eymas/WillyTheRobot/README.md

# WillyTheRobot
Minor FT - Project Willy The Robot
