eymas/WillyTheRobot/documentation/hardware-design/sections/glossary.tex

\section{glossary}
\begin{itemize}
\item \label{trm::imu} IMU - Inertia Measurement Unit, a sensor that can detect velocities in 3 to 9 axis.
\item \label{trm::PPR} PPR - Pulses Per Revolution, amount of signals generated in a single full rotation of the axis.
\end{itemize}
