eymas/WillyTheRobot/documentation/hardware-design/sections/MotorController.tex

\section{MotorController}

\subsection{Mechanical setup}

\subsection{Electrical setup}
At the start of the project the rotary encoders where disconnected and damaged. 
New rotary

The wiring for the sonars can be found in the schematic below (reused from previous group):

\begin{figure}[H]
\centering
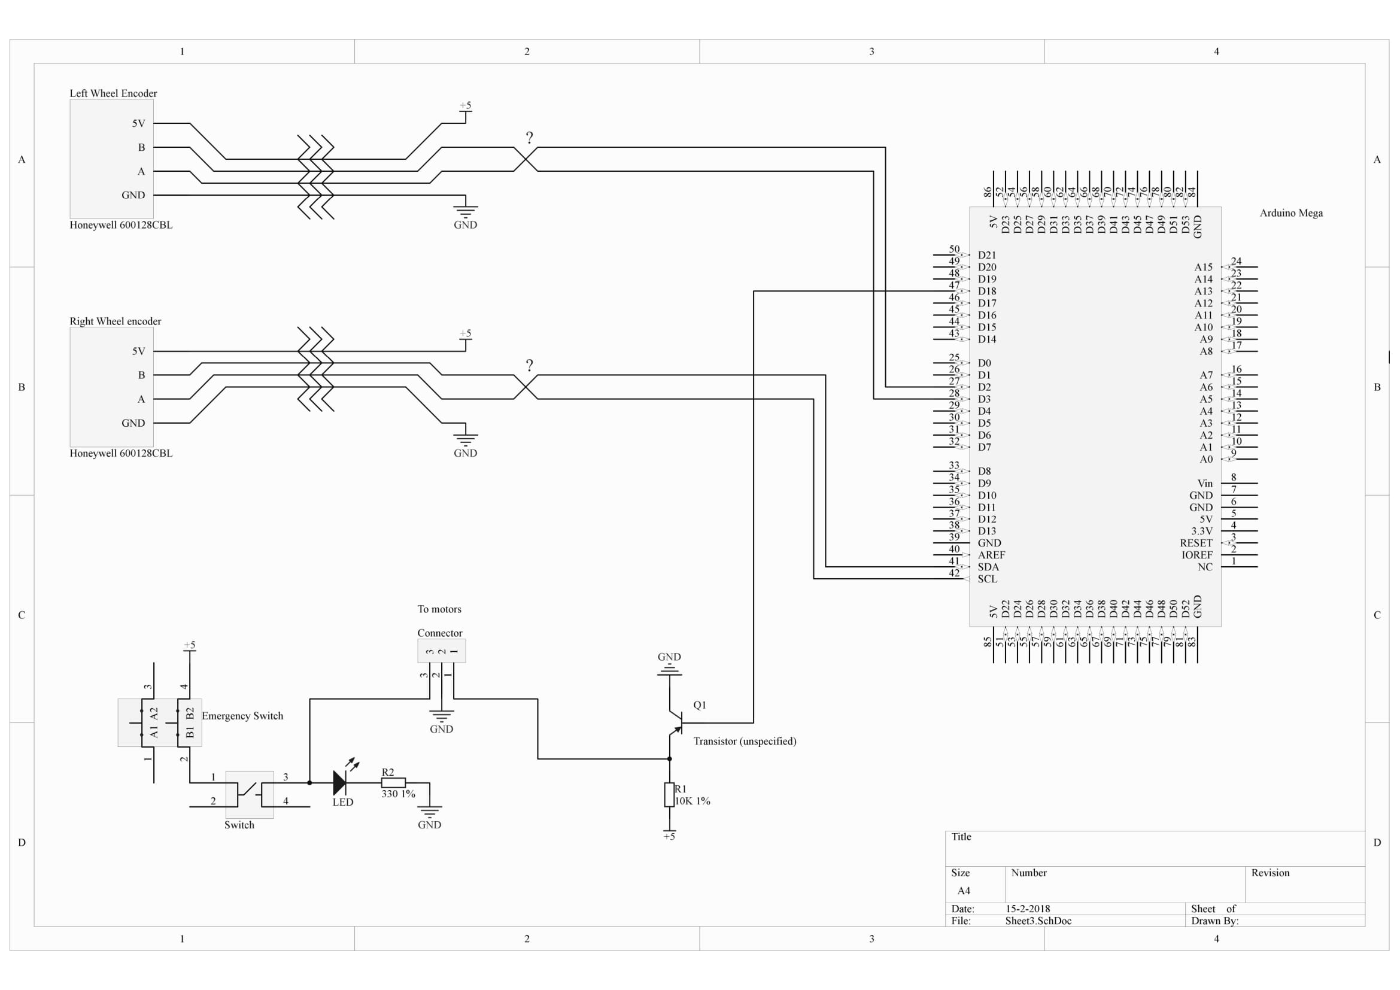
[picture p16: documentation/hardware-design/images/MotorController.jpg]

\caption{Wiring setup for the motor controller}
\label{fig::wiringMotor}
\end{figure}
