eymas/WillyTheRobot/documentation/tech-design/sections/glossary.tex

\section{Glossary}
\begin{itemize}
\item \label{trm::MSB} MSB  - Most Significant Bit(s)
\item \label{trm::LSB} LSB  - Least Significant Bit(s)
\item \label{trm::WTR} WTR  - Willy The Robot
\item \label{trm::PPR} PPR - Pulses per revolution
\item \label{trm::quad} Quadrature encoder - Two channel encoder with channel B phase shifted 90 degrees over channel A.
\end{itemize}
