eymas/WillyTheRobot/documentation/advice/sections/glossary.tex

\section{glossary}
\begin{itemize}
\item \label{trm::imu} IMU - Inertia Measurement Unit, a sensor that can detect velocities in 3 to 9 axis
\item \label{trm::wtr} WTR - Willy the Robot
\item \label{trm::kbs} KBS - \textit{Kenmerkende beroeps situatie}
\item \label{trm::asrs} ASRS - Automated storage and retrieval system
\item \label{trm::ros} ROS - Robotic operating system
\item \label{trm::rviz} RVIZ - 3D visualization tool for ROS
\item \label{trm::amcl} AMCL - Adaptive Monte Carlo Localization algorithm
\item \label{trm::teb} TEB - Timed Elastic Band
\item \label{trm::PGE} PGE - Penny \& Giles Motor controller, used in the base of the electric wheelchair
\end{itemize}
