eymas/WillyTheRobot/documentation/analysis-improvements/sections/closed-loop-control.tex

\section{Closed Loop Drive Control}
\subsection{Introduction}
WTR currently has an "open loop control system" \cite{openloop} that controls how it turns and drives.
There are no sensors used to provide feedback, which could be used to control and adjust accordingly.
This is a major drawback, because the robot is already quite difficult to control.
While it does not move very quickly, the motors have a lot of power behind them.
Should one of the wheels receive less power from the motor than the other, it will affect the trajectory of WTR, resulting in poor execution of the instructions, regardless of the accuracy of the path-finding.

\subsection{System Description}
\label{subs::SysDes}
WTR's mobility scooter base consists of two powered wheels at the front and two wheels on pivot each at the rear.
The two powered wheels each have a separate electrical motor.
This set-up is quite sensitive to small variations between the two motors, though it does allow for a good range of movements.

\subsection{Current Setup}
An Arduino Mega 2560 (based on the ATmega2560 \cite{ardMega}) is used to receive input from the laptop or Raspberry Pi used as core control unit, and then translates that into instructions for the motors from the mobility scooter.
The commands sent are translated into a corresponding power output of the wheels via the integrated motor controller of the scooter.
Two commands can be sent, one for the speed of the motors and one for rotation.
Both fall within a range of 100 to -100.
Unfortunately, this set-up does not allow for independent control of both motors, but an appropriate model of the system could be used to approximate that level of control through careful control of the turn variables.

\subsection{Improvements}
Two sensors will be added to the axles of both wheels, which allow WTR to use the speed and rotation of the wheels as feedback.
These sensors will be controlled via a micro-controller, likely an Arduino Uno \cite{ardUno}, since those are already available and simple to use.
This set-up would allow for an integrated closed loop control system using negative feedback.
An overview can be found in figure~\ref{fig::cllp}.
\begin{figure}[H]
\centering
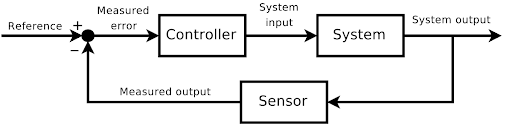
[picture p27: documentation/movement-research/images/controlmodel.png]

\caption{Example of the closed loop control system}
\label{fig::cllp}
\end{figure}
\newpage

\subsection{Model Of Control}
\subsubsection{Base}
As explained in 'System Description' \ref{subs::SysDes}, the motors can only be controlled through two output variables.
These two variables are \code{drive} output and \code{turn} output, both limited to values between 100 and -100.
These input are sent directly from the Arduino Mega, which applied the limits to the received values.
An overview can be found in table~\ref{tab::varoverview}
\begin{figure}[H]
\centering
\begin{tabular}{|l|l|c|c|l|l|}
\hline
\textbf{Nr.} & \textbf{Variable(s)} & \textbf{Left(+)} & \textbf{Right(-)} & \textbf{Min} & \textbf{Max} \\ \hline
1 & Input Turn 	& \multicolumn{2}{c|}{Turn\_Input} 				& - 		& -		\\ \hline
2 & Input Drive 	& \multicolumn{2}{c|}{Drive\_Input} 				& - 		& - 		\\ \hline
3 & Drive Output & \multicolumn{2}{c|}{Drive\_Output = Drive\_Input}	& -100 	& +100 	\\ \hline
4 & Turn Output 	& \multicolumn{2}{c|}{Turn\_Output = Turn\_Input}	& -100	& +100	\\ \hline
\end{tabular}
\caption{Overview of inputs and outputs of the original system}
\label{tab::varoverview}
\end{figure}

\subsubsection{Control Model}
To be able to create a controller which can control the speed of the wheels depending on input based on both the drive and input values, a direction definition has to be set up first.
The definition is:

\begin{itemize}
\item \code{Turning left will be a positive input value and a corresponding positive left wheel speed and a negative or lesser right wheel speed. Turning right will correspond with a negative input value and a positive right wheel speed and a negative or lesser left wheel speed}
\item \code{Moving forward corresponds with a positive input value and wheel speed, while moving backwards corresponds with a negative input value and negative wheel speed}
\end{itemize}

This definition is compliant with ROS and allows the construction of a control model which is shown in figure \ref{fig::controldiagram} and figure \ref{tab::closedoverview}.
The turn and drive inputs are received from ROS, the rotary encoders are read out by the arduino mega and the actual drive and turn speed are calculated.
Using both the reference speed inputs and the actual speeds the errors are calculated and send the PID controllers. 
These controllers then return an output signal which can be send to the motors.
The chosen controller $(C(s))$ is discussed here \ref{sec::controller}

\begin{figure}[H]
\centering
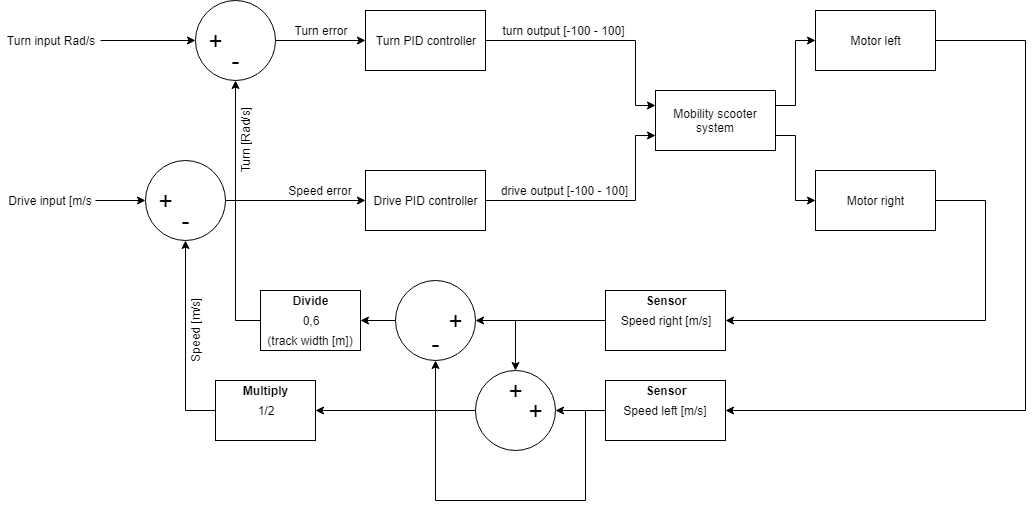
[picture p28: documentation/analysis-improvements/images/BlockDiagramCLCSR0.png]

\caption{Overview of the system integrated with closed loop control system}
\label{fig::controldiagram}
\end{figure}

\begin{figure}[H]
\centering
\begin{tabular}{|l|l|C{8cm}|c|c|}
\hline
\textbf{Nr.} 	& \textbf{Variable(s)}		&\textbf{Calculation}								         & \textbf{Unit} 	\\ \hline
1			    & Turn\_Input 			    & - 											             & [Rad/s] 		\\ \hline
2			    & Drive\_Input 				& - 											             & [m/s] 		    \\ \hline
3			    & Speed\_Sensor\_Right 		& $ Rad/s \cdot Wheel Radius $ 					         & [m/s] 		\\ \hline
4			    & Speed\_Sensor\_Left 		& $ Rad/s \cdot Wheel Radius $ 					         & [m/s] 		\\ \hline
5			    & Turn\_Speed				& $ (Speed\_Sensor\_Right - Speed\_Sensor\_Left)/0.6) $	 & [Rad/s]		\\ \hline
6			    & Drive\_Speed				& $ (Speed\_Sensor\_Right + Speed\_Sensor\_Left)/0.5) $ & [m/s]		    \\ \hline
5			    & Turn\_Error				& $ Turn\_Input - Turn\_Speed $						     & [Rad/s]		\\ \hline
6			    & Drive\_Error				& $ Drive\_Input - Drive\_Speed $ 					     & [m/s]		    \\ \hline
7			    & Turn\_Output  				& $ Turn\_Error \cdot Ct(s) $ 							 & - 			\\ \hline
8			    & Drive\_Output 				& $ Drive\_Error \cdot Cd(s) $							 & - 			\\ \hline

\end{tabular}
\caption{Overview of input and outputs in the closed loop system}
\label{tab::closedoverview}
\end{figure}
\footnotetext[1]{difference in max speed of the wheel while turning compared to max speed while driving straight}
\footnotetext[2]{Sensors must be able to determine turning direction}

\subsection{Controller}
\label{sec::controller}
The speed will be controlled by a PID-controller [\ref{trm::PIcontroller}], as shown in figure \ref{fig::picontrol}.
The initial gain will be controlled by the proportional factor $K\_p$ and the long term error by the integrating action $K\_i$. The $K\_i$ action has to be limited in order to prevent integral wind-up, and the $K\_p$ action has to be chosen so that it will not introduce too much overshoot and very little oscillation.

\begin{figure}[H]
\centering
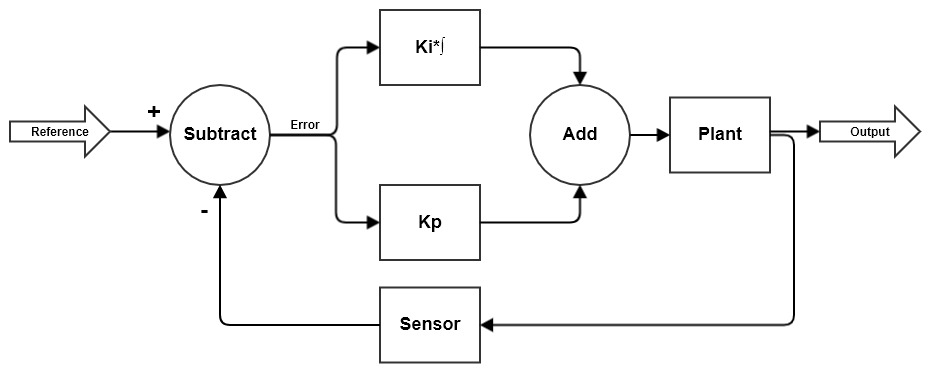
[picture p29: documentation/movement-research/images/BlockDiagramPI_R0.jpg]

\caption{PI-Controller}
\label{fig::picontrol}
\end{figure}

\newpage
