eymas/WillyTheRobot/documentation/tech-design/techdesign.tex

\documentclass{article} % article doctype, possible font size range from 8pt to 20pt with not all being avaiable.
\title{\huge Willy The Robot Technical Design Q1-Q2 2019}
\author{Jeroen van 't Hul\\S1139163  \and Thomas Zwaanswijk\\s1089273 \and Tom van den Noort\\s1101124}
\date{\parbox{\linewidth}{\centering
	\today\endgraf\bigskip
	Supervisor \hspace*{3cm} Main Stakeholder \endgraf\medskip
	Mischa Mol \hspace*{3cm} Ilja Clabbers \endgraf\bigskip
	Windesheim Zwolle\endgraf}} 

% include packages
\usepackage{graphicx}
\usepackage{caption}
\usepackage{mathabx}
\usepackage{wrapfig}
\usepackage[margin=1.0in]{geometry} % sets page margin, 2.0in is default.
\usepackage{titlesec}
\usepackage{hyperref}
\usepackage[table,xcdraw]{xcolor}
\usepackage{float}
\usepackage[export]{adjustbox}
\usepackage{todonotes}
\usepackage{indentfirst}
\usepackage{blindtext}
\usepackage{scrextend}
\usepackage{listings}
%\usepackage{siunitx}
%\usepackage{multirow}	% used for table multirow support
%\usepackage{longtable} % Allows tables to roll over into a new page.
\usepackage[nottoc,numbib]{tocbibind} % Adds bibliography / references to TOC and numbers that section.
\usepackage{array}
\usepackage{footnote}

% ----- custom commands ----- %
% Wrapper for paragraph command. Forces newline after paragraph title
\newcommand{\myparagraph}[1]{\paragraph{#1}\mbox{}\\} % Without \mbox{} all newlines will be ignored, making the first sentence appear on the same line as a paragraph title.
% monospace codeblock
\def\code#1{\texttt{#1}}
% changing the ToC depth in the document enviroment
\newcommand{\changelocaltocdepth}[1]{%
	\addtocontents{toc}{\protect\setcounter{tocdepth}{#1}}%
	\setcounter{tocdepth}{#1}%
}

\newcolumntype{L}[1]{>{\raggedright\let\newline\\\arraybackslash\hspace{0pt}}m{#1}}
\newcolumntype{C}[1]{>{\centering\let\newline\\\arraybackslash\hspace{0pt}}m{#1}}
\newcolumntype{R}[1]{>{\raggedleft\let\newline\\\arraybackslash\hspace{0pt}}m{#1}}

% general listing styling
\lstset{
	numbers=left,
	breaklines=true,
	backgroundcolor=\color{gray},
	tabsize=4,
	basicstyle=\ttfamily,
}

\makesavenoteenv{tabular}
\makesavenoteenv{table}

\setcounter{tocdepth}{2} % only part,chapters,sections, subsections appear in ToC

\addtokomafont{labelinglabel}{\sffamily}

\DeclareCaptionFormat{cancaption}{#1#2#3\par} % Normal format actually
\DeclareCaptionLabelFormat{cancaptionlabel}{#1}
\captionsetup[figure][number]{format=cancaption,labelformat=cancaptionlabel}
\graphicspath { {images/}{../images/} }

\begin{document}
\maketitle

\begin{figure}[H]
\centering

\end{figure}
\thispagestyle{empty}
\newpage
\setcounter{page}{1}
\tableofcontents
\newpage

% Sections
\input{sections/introduction.tex}
\input{sections/ROS.tex}
\input{sections/motor-controller.tex}
\input{sections/imu.tex}
\input{sections/teb-local-planner.tex}

\appendix % all sections after this are appendices
\input{sections/glossary.tex}
% Bibliography:
\newpage
\bibliographystyle{ieeetr}
\bibliography{references}

\end{document}
