eymas/WillyTheRobot/documentation/project-agreements/sections/schedule.tex

\section{Schedule}
The following table describes the schedule of the project.
\begin{center}
\begin{tabular}{|l|l|}
\hline
\textbf{Week} & \textbf{Activities} \\ \hline
1: 28 January 2019 & Introduction \\ \hline
2: 4 February 2019 & Start sprint 0 \\ \hline
3: 11 February 2019 & Start sprint 1 \\ \hline
4: 18 February 2019 & Holiday \\ \hline
5: 25 February 2019 &  \\ \hline
6: 4 March 2019 & Start sprint 2 \\ \hline
7: 11 March 2019 &  \\ \hline
8: 18 March 2019 & Start sprint 3 \\ \hline
9: 25 March 2019 &  \\ \hline
10: 1 April  2019 & Start sprint 4 \\ \hline
11: 8 April 2019 &  \\ \hline
12: 15 April 2019 & Start sprint 5 \\ \hline
13: 22 April 2019 &  \\ \hline
14: 29 April 2019 & Start sprint 6 \\ \hline
15: 6 May 2019 &  \\ \hline
16: 13 May 2019 & Start sprint 7 \\ \hline
17: 20 May 2019 &  \\ \hline
18: 27 May 2019 & Start sprint 8 \\ \hline
19: 3 June 2019 &  \\ \hline
20: 10 June 2019 & Project deadline \\ \hline
\end{tabular}
\end{center}

\subsection{Global Sprint Planning}
\noindent \textbf{Sprint 0}\\
Introduction of the projects, team building, contacting stakeholders, project plan, contact with previous groups\\
\textbf{Sprint 1}\\
Getting to grips with Willy and ROS (Robotic Operating System), update WillyWiki\\
\textbf{Sprint 2}\\
Tweak file structure, work on manual controls and diagnose problems\\
\textbf{Sprint 3}\\
begin updating controls on Willy\\
\textbf{Spring 4}\\
Start work on move\_ base update to accommodate rotary encoders\\
\textbf{Sprint 5}\\
Adapt emergency behaviours to accommodate WTR's unusual structure\\
\textbf{Sprint 6} \\
Continue autonomous driving\\
\textbf{Sprint 7}\\
Testing\\
\textbf{Sprint 8}\\
Bugfixing + preparation for Winnovation \\

Any spare time will be dedicated to improving other features, but the scope of those is dependent of whether or not any time is left, and the interest of the group itself.
Additionally, the way Willy is currently built leaves a lot to be desired, so in any spare time improvements in the mounting of hardware and cable-management will also be made.

\newpage
