eymas/WillyTheRobot/documentation/advice/images/rosOverview.png

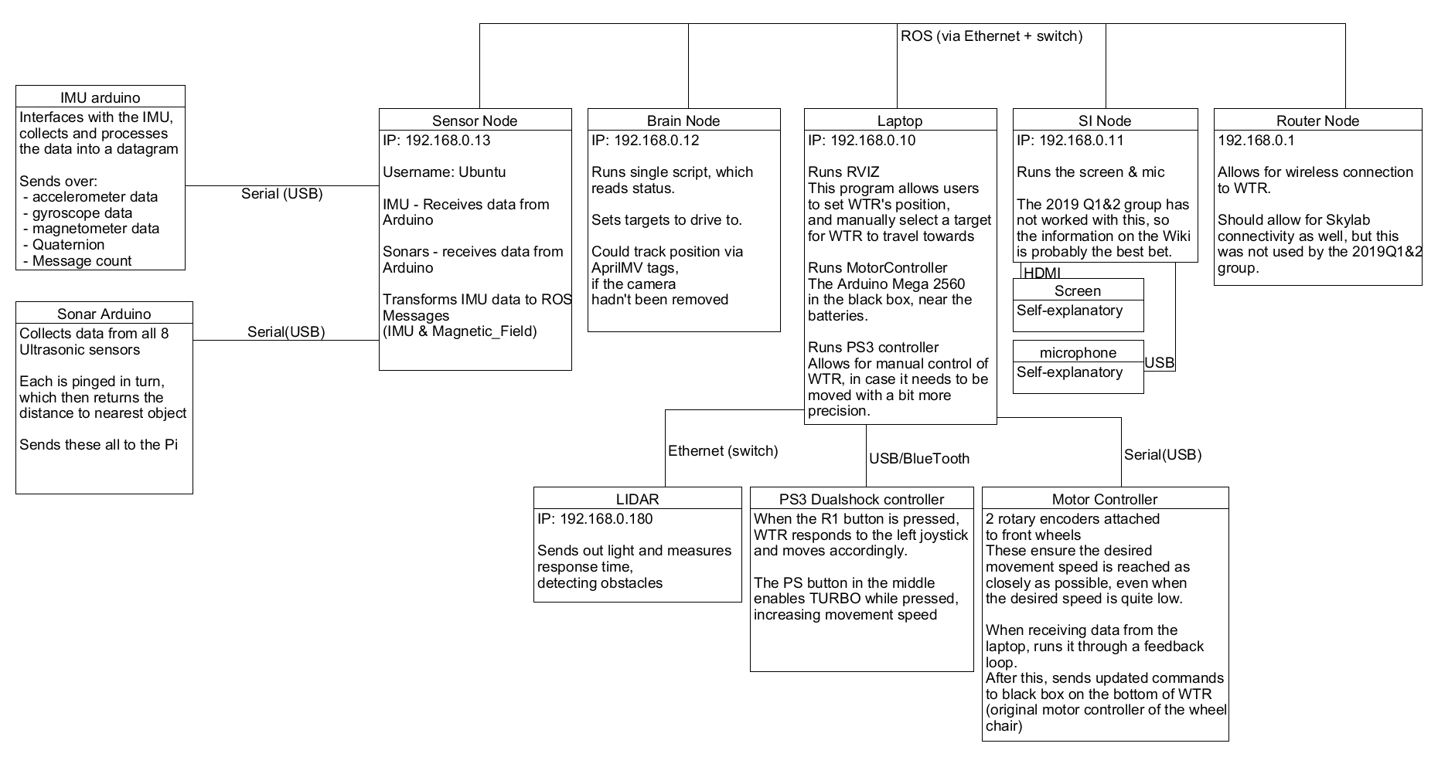
documentation/advice/images/rosOverview.png
