eymas/WillyTheRobot/code/IMU 9250 to serial/mpu6050_serial_to_imu/arduino/MPU9250/MPU9250.ino

/* MPU9250 Basic Example Code
  by: Kris Winer
  date: April 1, 2014
  license: Beerware - Use this code however you'd like. If you
  find it useful you can buy me a beer some time.
  Modified by Brent Wilkins July 19, 2016

  Demonstrate basic MPU-9250 functionality including parameterizing the register
  addresses, initializing the sensor, getting properly scaled accelerometer,
  gyroscope, and magnetometer data out. Added display functions to allow display
  to on breadboard monitor. Addition of 9 DoF sensor fusion using open source
  Madgwick and Mahony filter algorithms. Sketch runs on the 3.3 V 8 MHz Pro Mini
  and the Teensy 3.1.

  SDA and SCL should have external pull-up resistors (to 3.3V).
  10k resistors are on the EMSENSR-9250 breakout board.

  Hardware setup:
  MPU9250 Breakout --------- Arduino
  VDD ---------------------- 3.3V
  VDDI --------------------- 3.3V
  SDA ----------------------- A4
  SCL ----------------------- A5
  GND ---------------------- GND
*/

#include "quaternionFilters.h"
#include "MPU9250.h"


//#define DEBUG
#define AHRS false         // Set to false for basic data read
const int kQuaternionMultFact = 100;
const int kBytesToSend = 45;
const int kSamplesPerAverage = 10;
float accel_data[3][kSamplesPerAverage];
float gyro_data[3][kSamplesPerAverage];
float mag_data[3][kSamplesPerAverage];
float accel_avg[3], gyro_avg[3], mag_avg[3];
float axs, ays, azs, gxs, gys, gzs, mxs, mys, mzs;

// Pin definitions
int intPin = 12;  // These can be changed, 2 and 3 are the Arduinos ext int pins
int myLed  = 13;  // Set up pin 13 led for toggling

uint8_t message_count = 0;

#define I2Cclock 400000
#define I2Cport Wire
#define MPU9250_ADDRESS MPU9250_ADDRESS_AD0   // Use either this line or the next to select which I2C address your device is using
//#define MPU9250_ADDRESS MPU9250_ADDRESS_AD1

MPU9250 myIMU(MPU9250_ADDRESS, I2Cport, I2Cclock);

void setup()
{
  Wire.begin();
  // TWBR = 12;  // 400 kbit/sec I2C speed
  Serial.begin(38400);

  while (!Serial) {};
  pinMode(myLed, OUTPUT);
  digitalWrite(myLed, HIGH);


  // Read the WHO_AM_I register, this is a good test of communication
  byte c = myIMU.readByte(MPU9250_ADDRESS, WHO_AM_I_MPU9250);

  if (c == 0x73) // WHO_AM_I should always be 0x71, but the chip used could be a knockoff
  {
    // Start by performing self test
    myIMU.MPU9250SelfTest(myIMU.selfTest);

    // Calibrate gyro and accelerometers, load biases in bias registers
    myIMU.calibrateMPU9250(myIMU.gyroBias, myIMU.accelBias);
        Serial.println(myIMU.gyroBias[0]);
        Serial.println(myIMU.gyroBias[1]);
        Serial.println(myIMU.gyroBias[2]);
    myIMU.initMPU9250();
    // Initialize device for active mode read of acclerometer, gyroscope, and
    // temperature

    // Read the WHO_AM_I register of the magnetometer, this is a good test of
    // communication
    byte d = myIMU.readByte(AK8963_ADDRESS, WHO_AM_I_AK8963);

    if (d != 0x48)
    {
      abort();
    }

    // Get magnetometer calibration from AK8963 ROM
    myIMU.initAK8963(myIMU.factoryMagCalibration);
    // Get sensor resolutions, only need to do this once
    myIMU.getAres();
    myIMU.getGres();
    myIMU.getMres();

    myIMU.magBias[0] = -39.04;
    myIMU.magBias[1] = -129.98;
    myIMU.magBias[2] = -48.05;

    myIMU.magScale[0] = 0.66;
    myIMU.magScale[1] = 1.36;
    myIMU.magScale[2] = 1.33;

  } // if (c == 0x73)
  else
  {
    abort();
  }
}

void loop()
{
  for (uint8_t j = 0; j < 3; j++) {
    for (uint8_t i = 0; i < (kSamplesPerAverage - 1); i++) {
      accel_data[j][i + 1] = accel_data[j][i];
      gyro_data[j][i + 1] = gyro_data[j][i];
      mag_data[j][i + 1] = mag_data[j][i];
    }
  }
  // If intPin goes high, all data registers have new data
  // On interrupt, check if data ready interrupt
  if (myIMU.readByte(MPU9250_ADDRESS, INT_STATUS) & 0x01)
  {
    myIMU.readAccelData(myIMU.accelCount);  // Read the x/y/z adc values
    myIMU.readGyroData(myIMU.gyroCount);  // Read the x/y/z adc values
    myIMU.readMagData(myIMU.magCount);  // Read the x/y/z adc values
    for (uint8_t i = 0; i < 3; i++) {
      accel_data[i][0] = static_cast<float>(myIMU.accelCount[i]);
      gyro_data[i][0] = static_cast<float>(myIMU.gyroCount[i]);
      mag_data[i][0] = static_cast<float>(myIMU.magCount[i]);
    }
    for (uint8_t j = 0; j < 3; j++) {
      for (uint8_t i = 0; i < kSamplesPerAverage; i++) {
        accel_avg[j] += accel_data[j][i];
        gyro_avg[j]  += gyro_data[j][i];
        mag_avg[j]   += mag_data[j][i];
      }
      //      #ifdef DEBUG
      //      Serial.print("mavg = ");
      //      Serial.println(mag_avg[j]);
      //      #endif
    }
    for (uint8_t i = 0; i < 3; i++) {
      accel_avg[i] = accel_avg[i] / kSamplesPerAverage;
      gyro_avg[i] = (gyro_avg[i] / kSamplesPerAverage);
      mag_avg[i] = mag_avg[i] / kSamplesPerAverage;
      //      #ifdef DEBUG
      //      Serial.print("mavg/kSamplesPerAverage = ");
      //      Serial.println(mag_avg[i]);
      //      #endif
    }

    // Now we'll calculate the accleration value into actual g's
    // This depends on scale being set
    // Some vars are inverted because testing showed they were inverted.
    myIMU.ax = -((accel_avg[0] * myIMU.aRes) - myIMU.accelBias[0]);
    myIMU.ay = -((accel_avg[1] * myIMU.aRes) - myIMU.accelBias[1]);
    myIMU.az = (accel_avg[2] * myIMU.aRes) - myIMU.accelBias[2];
    // Calculate the gyro value into actual degrees per second
    // This depends on scale being set
    myIMU.gx = (gyro_avg[0] * myIMU.gRes - myIMU.gyroBias[0]);
    myIMU.gy = -(gyro_avg[1] * myIMU.gRes - myIMU.gyroBias[1]);
    myIMU.gz = -(gyro_avg[2] * myIMU.gRes - myIMU.gyroBias[2]);
    //#ifdef DEBUG
    //    Serial.print('(');
    //    Serial.print(myIMU.gx);
    //    Serial.print(",");
    //    Serial.print(myIMU.gy);
    //    Serial.print(",");
    //    Serial.print(myIMU.gz);
    //    Serial.println(')');
    //#endif
    // Calculate the magnetometer values in milliGauss
    // Include factory calibration per data sheet and user environmental
    // corrections
    // Get actual magnetometer value, this depends on scale being set
    mxs = ((mag_data[0][0]) * myIMU.mRes * myIMU.factoryMagCalibration[0]) - myIMU.magBias[0];
    // these are just used for quaternion calcs, which don't need an average.
    mys = ((mag_data[1][0]) * myIMU.mRes * myIMU.factoryMagCalibration[1]) - myIMU.magBias[1];
    mzs = ((mag_data[2][0]) * myIMU.mRes * myIMU.factoryMagCalibration[2]) - myIMU.magBias[2];

    axs = ((accel_data[0][0]) * myIMU.aRes) - myIMU.accelBias[0];
    ays = ((accel_data[1][0]) * myIMU.aRes) - myIMU.accelBias[1];
    azs = ((accel_data[2][0]) * myIMU.aRes) - myIMU.accelBias[2];

    gxs = ((gyro_data[0][0]) * myIMU.gRes);// - myIMU.gyroBias[0];
    gys = ((gyro_data[1][0]) * myIMU.gRes);// - myIMU.gyroBias[1];
    gzs = ((gyro_data[2][0]) * myIMU.gRes);// - myIMU.gyroBias[2];

    myIMU.mx = (float)mag_avg[0] * myIMU.mRes
               * myIMU.factoryMagCalibration[0] - myIMU.magBias[0];
    myIMU.my = (float)mag_avg[1] * myIMU.mRes
               * myIMU.factoryMagCalibration[1] - myIMU.magBias[1];
    myIMU.mz = (float)mag_avg[2] * myIMU.mRes
               * myIMU.factoryMagCalibration[2] - myIMU.magBias[2];
    //#ifdef DEBUG
    //    Serial.print("accel(");
    //    Serial.print(myIMU.ax);
    //    Serial.print(",");
    //    Serial.print(myIMU.ay);
    //    Serial.print(",");
    //    Serial.print(myIMU.az);
    //    Serial.println(')');
    //    Serial.print("gyro(");
    //    Serial.print(myIMU.gx);
    //    Serial.print(",");
    //    Serial.print(myIMU.gy);
    //    Serial.print(",");
    //    Serial.print(myIMU.gz);
    //    Serial.println(')');
    //    Serial.print("mag(");
    //    Serial.print(myIMU.mx);
    //    Serial.print(",");
    //    Serial.print(myIMU.my);
    //    Serial.print(",");
    //    Serial.print(myIMU.mz);
    //    Serial.println(')');
    //#endif
  } // if (readByte(MPU9250_ADDRESS, INT_STATUS) & 0x01)

  // Must be called before updating quaternions!
  myIMU.updateTime();

  // Sensors x (y)-axis of the accelerometer is aligned with the y (x)-axis of
  // the magnetometer; the magnetometer z-axis (+ down) is opposite to z-axis
  // (+ up) of accelerometer and gyro! We have to make some allowance for this
  // orientation mismatch in feeding the output to the quaternion filter. For the
  // MPU-9250, we have chosen a magnetic rotation that keeps the sensor forward
  // along the x-axis just like in the LSM9DS0 sensor. This rotation can be
  // modified to allow any convenient orientation convention. This is ok by
  // aircraft orientation standards! Pass gyro rate as rad/s
  // madgwick is more intensive, but more accurate. If the arduino cannot deal with the amount of calculations
  // switch to Mahony.
  //  MadgwickQuaternionUpdate(axs, ays, azs, gxs * DEG_TO_RAD,
  //                           gys * DEG_TO_RAD, gzs * DEG_TO_RAD, mys,
  //                           mxs, mzs, myIMU.deltat);
  MahonyQuaternionUpdate(axs, ays, azs, gxs * DEG_TO_RAD,
                         gys * DEG_TO_RAD, gzs * DEG_TO_RAD, mys,
                         mxs, -mzs, myIMU.deltat);
  myIMU.count = millis();

  uint8_t transmit_buffer[kBytesToSend];
  // transmits the start bytes
  transmit_buffer[0] = '$';
  transmit_buffer[1] = 0x03;
  /* transmit quaternion bytes
     rather than transmit floats, which take a lot of bytes (4 each) instead they are multiplied by 100 (ignoring everything more than 2 decimal places behind the 0
     This allows for them to be transmitted as integers, without significant impact.
     Kind of a workaround, there is probably a neater method out there.
  */
  for (uint8_t i = 0; i < 4; i++) {
    int8_t quaternion_value = (*(getQ() + i)) * kQuaternionMultFact;
    transmit_buffer[2 + i] = quaternion_value;
#ifdef DEBUG
    Serial.print("quatval: " );
    Serial.print(*(getQ() + i));
#endif
  }
  // transmit accelerometer data
  /*
      The data here is split into four bytes.
    The reason for this is that floats are 32 bits datatypes, and serial can only transmit 8-bit integers.
     As such, each float is split into an array of 4 unsigned interegers
     each of which are then added to the transmit_buffer
  */
  uint8_t *accel_array_x = reinterpret_cast<uint8_t*>(&accel_avg[0]);
  uint8_t *accel_array_y = reinterpret_cast<uint8_t*>(&accel_avg[1]);
  uint8_t *accel_array_z = reinterpret_cast<uint8_t*>(&accel_avg[2]);

  uint8_t *gyro_array_x = reinterpret_cast<uint8_t*>(&gyro_avg[0]);
  uint8_t *gyro_array_y = reinterpret_cast<uint8_t*>(&gyro_avg[1]);
  uint8_t *gyro_array_z = reinterpret_cast<uint8_t*>(&gyro_avg[2]);

  uint8_t *magnet_array_x = reinterpret_cast<uint8_t*>(&mag_avg[0]);
  uint8_t *magnet_array_y = reinterpret_cast<uint8_t*>(&mag_avg[1]);
  uint8_t *magnet_array_z = reinterpret_cast<uint8_t*>(&mag_avg[2]);

  for (uint8_t i = 0; i < 4; i++) {
    transmit_buffer[6 + i] = accel_array_x[i];
    transmit_buffer[10 + i] = accel_array_y[i];
    transmit_buffer[14 + i] = accel_array_z[i];
    transmit_buffer[18 + i] = gyro_array_x[i];
    transmit_buffer[22 + i] = gyro_array_y[i];
    transmit_buffer[26 + i] = gyro_array_z[i];
    transmit_buffer[30 + i] = magnet_array_x[i];
    transmit_buffer[34 + i] = magnet_array_y[i];
    transmit_buffer[38 + i] = magnet_array_z[i];
    //#ifdef DEBUG
    //    Serial.print(myIMU.accelCount[0]);
    //    Serial.print(">");
    //    Serial.print(accel_avg[0]);
    //    Serial.print("-->");
    //    Serial.print(accel_array_x[i]);
    //    Serial.print("&&");
    //    Serial.println(transmit_buffer[6 + i]);
    //#endif
  }
  transmit_buffer[42] = message_count;
  transmit_buffer[43] = '\r';
  transmit_buffer[44] = '\n';  // terminating characters for the raspberry Pi
  Serial.write(transmit_buffer, kBytesToSend);
  message_count++;

  myIMU.count = millis();
  myIMU.sumCount = 0;
  myIMU.sum = 0;
}
