eymas/WillyTheRobot/(commit log)

2019-02-08 Began a Business case Added problems, cost and benefit section (needs risk analysis)
2019-02-11 Added business case setup
2019-02-11 Added movement research section Not finished yet Supposed to be an analysis of WTR's current capabilities in driving.
2019-02-11 Updated business case and references.
2019-02-15 Updated business case, summary and motivation to include new scope
2019-02-15 added .docx & .doc to gitignore. Added physical issues section - document current physical issues that need to be adressed.
2019-02-15 Updated physical problems section to cover the battery situation.
2019-02-25 Added conclusion, updated small bits and detailed issues with sensors.
2019-02-28 first commit, should have working code to read 9-axis IMU
2019-03-05 Merged motorcontroller + control loop
2019-03-06 Added comments and tuned PID to basic P controller.
2019-03-08 Added info on IMU protocol
2019-03-12 Optimized PID calculation: Removed I and D calculation
2019-03-12 Merge branch 'code/test/motor-controller' of https://github.com/eymas/WillyTheRobot into doc/movement-research
    # Conflicts:
    # code/MotorTest/MotorTest.ino
2019-03-12 Code adapted to work with IMU viewer
2019-03-12 This is a viewer to get insight in the orientational beheaviour of the 9 axis IMU
2019-03-12 changed format in which data is printed
2019-03-12 added labels to readings printed to serial2
2019-03-13 Made preliminary efforts to begin transmitting data to the PI from the arduino after gathering data from IMU
2019-03-13 Arduino can now send the data in a format that can be read byte for byte by the Pi Started documentation to ensure future groups can work on this.
2019-03-14 Added in modified code from previous groups. Removed obsolete inos.
    [ImuFilterMadgwick.cfg]
2019-03-15 Working on detection of no connection with encoders
2019-03-15 Reoved references to temperature, and added magneticfield message with unknown covariance
2019-03-19 removed pointless debug lines in the arduino code, added more explanations in the tech design.
2019-03-21 commented out a missed temperature related function.
2019-03-21 added description of motortest
2019-04-02 fixed baudrate in arduino code, added more debug messages to Pi Code
    [MPU9250.ino]
2019-04-02 Changed time stamp method, added extra safety by continue forcing to send a 0 to the motor
2019-04-02 remove bracket
2019-04-08 Fixed error in quaternion value processing on Pi side. Formatted arduino code better.
    [MPU9250.ino]
2019-04-08 removed debug that's no longer necessary, added new debug for values of accelerometer which seem to be static or memory adresses.
2019-04-09 Fixed typo in arduino comments. Added normalization to Pi code.
    [MPU9250.ino]
2019-04-09 added debug code to see why same values keep getting printed.
2019-04-09 removed attempt to fix printing by using pointers.
2019-04-09 Lowered baudrate to see if this reduces missed packets.
    [MPU9250.ino]
2019-04-09 added small delay to see if that fixes missed packages, removed debug code from Pi code
    [MPU9250.ino]
2019-04-09 Added anti windup to PID controller. Reworked turn calculations Retuned PID parameters accordingly
    [ControlLoop.h, Encoder.h, MotorTest.ino, PIDCalculation.h]
2019-04-09 added more debug code to check what causes error in missed messages
    [MPU9250.ino]
2019-04-10 Changed wheel radius and tuned PID accordingly
2019-04-10 Debugging IMU
2019-04-11 Updated hardware design to reflect on choices made about choosing an IMU
2019-04-11 Prevented device from reading buffer if $ was received but new data wasn't yet available
2019-04-12 changed print to write where necessary, changed Pi code to respond as needed
2019-04-15 Additional debug messages & separation of some messages/variables being printed
2019-04-15 removed input echo; screws up character encoding. added debug messages on input clearing.
2019-04-15 Increased received bytes to 28, need to check this on Arduino side (should only send 27 by my count), moved debug code around.
2019-04-15 Moved variables around in Arduino to make more sense, added MilliGauss to Tesla conversion
2019-04-15 Changed ros time measurement and added debug print for it.
2019-04-16 subtracts bias from accelerometer values now, removed old code from Pi
2019-04-16 Removed superfluous calibrations that are already done on the arduino side, and as such were done twice.
2019-04-16 added magnetic biases and debug code (uncomment to see serial print)
2019-04-17 added brackets to hopefully fix the issue of invalid operands.
2019-04-17 changed arduino values to float, instead of 16 bit integers
2019-04-17 discovered order of transmitted data was affecting how it was interpreted on the other end. Fixed issue
    [MPU9250.ino]
2019-04-17 and another counting error.
    [MPU9250.ino]
2019-04-17 added more brackets for organization
2019-04-18 Updated documentation in TD for IMU handling
2019-04-18 Updated hardware design to have hookup schematic for MPU9250
2019-04-18 reworked comments and added safety by reading out the emergency and disabling the PID controller when emergency is active in order to prevent intergral windup
    [ControlLoop.h, Encoder.h, MotorTest.ino, PIDCalculation.h]
2019-04-18 added factor to mitigate the gyro values.
2019-04-18 Sonar first work updated python to be used on Pi, with 8 sensors updated R2 version for arduino
2019-04-23 Moved altering orientation to arduino in order to allow quaternion to be correct, cleaned up code by removing magic numbers (aside from 3, which is the number of dimensions and should remain the same)
    [MPU9250.ino]
2019-04-23 Changed serial device path, debug messages and other fixes
    [sonar-read.py]
2019-04-24 Fixed topic names to adhere to conventions
    [sonar-read.py]
2019-04-24 removed code that should not be here
    [ImuFilterMadgwick.cfg]
2019-04-24 removed some old code that was pointless, changed quaternions to not use the averaged values. Explained why the IMU will have to be moved.
2019-05-06 Reworked analyses documentation and flowcharts to match the written software
2019-05-06 Created section on motorcontrollers.
2019-05-08 Added comments and changed maximum distance to 200 cm
2019-05-09 updated motorcontroller architecture, added images, added discriptions
2019-05-09 Added diagram that shows wiring of motorcontroller, added explanation to some sections on why parts are necessary.
2019-05-09 wrote section on 3-d printed components.
2019-05-10 Fixed orientation of IMU.
    [MPU9250.ino]
2019-05-14 Added section on the encoders and to add a check for connection.
2019-05-14 Added sonars in correct branch :/
2019-05-15 added square brackets around two of the refs, as they're confusing otherwise
2019-05-17 added square brackets to all references to make them look nicer.
2019-05-17 Added brackets to references Changed minor mis-spellings
2019-05-20 Added print statements to print parts of quaternion
2019-05-20 added brackets to print statement
2019-05-20 adapted code to use mahoney, as its less intensive, as well as reversing the Z axis which seems to have fixed quaternion orientation
    [MPU9250.ino]
2019-05-20 removed duplicate bias subtraction from GYRO resulting in massive drift.
    [MPU9250.ino]
2019-05-21 reverted to working code
    [MPU9250.ino]
2019-05-24 Created section on changes regarding the batteries and the wiring
2019-05-24 Fixed minor mistakes, added diagram showing full wiring setup
2019-05-27 Moved motor controller code to map called motorcontroller, and fixed small mistakes.
    [ControlLoop.h, Encoder.h, MotorTest.ino, PIDCalculation.h]
2019-05-29 Added startup scripts & instructions from the sensornode to repository
